DitroniX/IPEM-IoT-Power-Energy-Monitor/README.md

## IPEM ESP32 ATM90E32 ATM90E36 IoT Power Energy Monitor SDK

### NOTE: 20th March 2026. This version of IPEM has been superseded with the new improved [IPEM Plus](https://github.com/DitroniX/IPEM-Plus-ESP32-C5-LoRa-LoRaWAN-IoT-Mains-Power-Energy-Monitor)
**IPEM Plus**  is a self-contained ESP32-C5 based IoT monitoring board. Ideal for local, or remoting, monitoring requirements.

**IPEM Plus**  connectivity allows Wi-Fi connections to 2.4GHz or 5GHz, with Bluetooth, Thread and Zigbee. In addition, you may also use the inbuilt LoRa Radio IoT 850 MHz through to 930 MHz.

### [Compare Mains Power IoT Energy Monitors](https://github.com/DitroniX/IPEM-Plus-ESP32-C5-LoRa-LoRaWAN-IoT-Mains-Power-Energy-Monitor/wiki/Compare-Mains-Power-IoT-Energy-Monitors)
-----------
### Original IPEM E32 and E36

**250112 UPDATED FIRMWARE**: [**FliX**](https://github.com/DitroniX/FLIX-DitroniX-Power-Energy-Monitors-Firmware) is an Integrated Firmware for DitroniX Power Energy Monitor SDK Boards

IPEM Overview
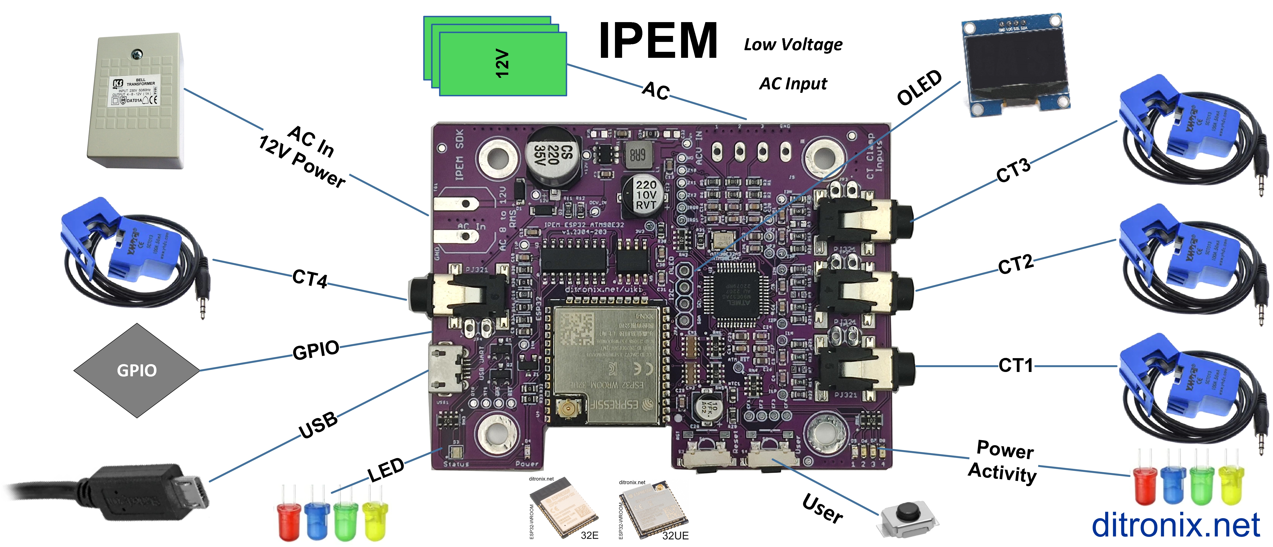
[picture p1: Datasheets and Information/IPEM Power Energy Monitor Board Overview.jpg]
Display-Type-B


The IPEM Kit
Display-Type-B

IPEM with OLED
Display-Type-B

**DitroniX.net Power Energy Monitor Boards SDK Overview**
Display-Type-B
------------

**IPEM Production - 3D Render**
Display-Type-B

**IPEM with Integrated Push OTA Example**
Display-Type-B
Display-Type-B 

**IPEM Example Real-Time Output to ThingSpeak**
Display-Type-B

**IPEM Example Real-Time Output to ThingSpeak into ThingChart on Mobile Phone App**
Display-Type-B

Four fully tested versions of this board are available. Thye most popular being ESP32E (PCB Ant), plus ATM90E32.

The board layout is designed to be a flexible dual purpose.
- ESP32 WROOM, with Internal Antenna, or UF.L connector for external antenna
- ATM90E32 or ATM90E36

**CT Clamp Inputs**

The forth CT input on the ATM90E32 board, which is included for the ATM90E36, now remains on the board and goes to the ESP32 ADC.  So both 
board variants will have FOUR CT inputs. 

- **ATM90E32**
 - 3 x CT Line inputs to the ATM chip.
 - 1 x CT input to the ESP32 ADC.

- **ATM90E36**
 - 3 x CT Line inputs to the ATM chip.
 - 1 x CT N input to the ATM chip or CT to ESP32 ADC
 - Alternative 1 x CT input to the ESP32 ADC.

------------

**IPEM with Transformer**

Display-Type-B

 The **IPEM IoT Power Energy Monitor** board main features:
 - **Compact** and **Flexible Design** SDK Board
	 - All connections are **low voltage**, for **safe operation**
	 - **Easy to interface**
 - *Optional* **Espressif** **ESP32** **WROOM**
	 - **ESP32-WROOM-32E-N4** 
		 - Integral Antenna Wireless and Bluetooth  
	 - **ESP32-WROOM-32UE-N4** 
		 - Ext Antenna - U.FL Socket 
		 - Wireless and Bluetooth
 - *Optional* **ATM90E** Series
	 - **ATM90E32** Energy Monitor 
		 - 3 x Phases Line CT Clamp Input  
			 -  Example YHDC SCT013000
		 - 3 x Voltage Inputs (AC RMS)
		 - Power Modes Settings
	 - **ATM90E36** Energy Monitor 
		 - 3 x Phases Line CT Clamp Input 
			 -  Example YHDC SCT013000
		 - 3 x Voltage Inputs (AC RMS) 
		 - 1 x Phase Neutral CT Clamp
		 - DMA Mode (Logging via SPI)
		 - Power Modes Settings
		 - Auto DMA selection opton via GP12
 - **24C64** EEPROM 
	 - Parameter Settings
	 - Logging
 - **OLED I2C**
	 - I2C Interface
	 - OLED I2C Connector
		 - Configurable Power Pins
 - **AC Low Voltage** Input (for Safety)
	 - Power safely derived from a SELV / Wall AC/AC Power Supply 
		 - 8 to 12V AC RMS
		 - Examples GreenBrook DAT01A or TLC TC TR7
 - Onboard **3V3 DC SMPS** Power Supply
	 - Power taken from AC Input
 - Arduino **Wemos D1 Compatible** USB Interface
	 - On-board Micro USB Socket
	 - Flashing and Programming
	 - Example wemos_d1_mini32
	 - Can also used to power the board
	 - Debugging
 - On Board **NTC** (Temperature) 
 - **USER GPIO/UART**
	 - 2 GPIO for User (GP16 and GP17)
	 - UART Interfacing (UART 2)
 - **Reset Button** 
 - User **Programmable Button** 
 - **RGB Status LED**
	 - User Configurable
 - **Power LED**
	 - On 3V3 
 - **ATM CT LEDs**
	 - CF1 - Active 
	 - CF2 - ReActive
	 - CF3 - Fundamental
	 - CF4 - Harmonic
 - PCB designed to fit into an BMC enclosure 
	 - Also allows for the display to be included, or not. 
 - **Size** 70 mm x 53 mm

------------

**In The Box**

Display-Type-B

External Antenna Version
Display-Type-B

Our SDKs are WeMos D1 Mini flashing compatible
Set the BOARD to ESP32, 'WEMOS D1 MINI ESP32' DEV Module (or similar).
You can also set the BAUD rate to 921600 to speed up flashing.
The SDK does NOT need external power to flash. It will take Power from the USB 5V.
You will need to provide external 12V AC for power up of the Energy Monitor functions. You will need to provide a CT Current Clamp. Ideally YHDC SCT-013-000

All test code is OPEN SOURCE and although is is not intended for real world use, it may be freely used, or modified as needed. It is distributed on an "AS IS" BASIS, WITHOUT WARRANTIES OR CONDITIONS OF ANY KIND, either express or implied.

## **Purchase**
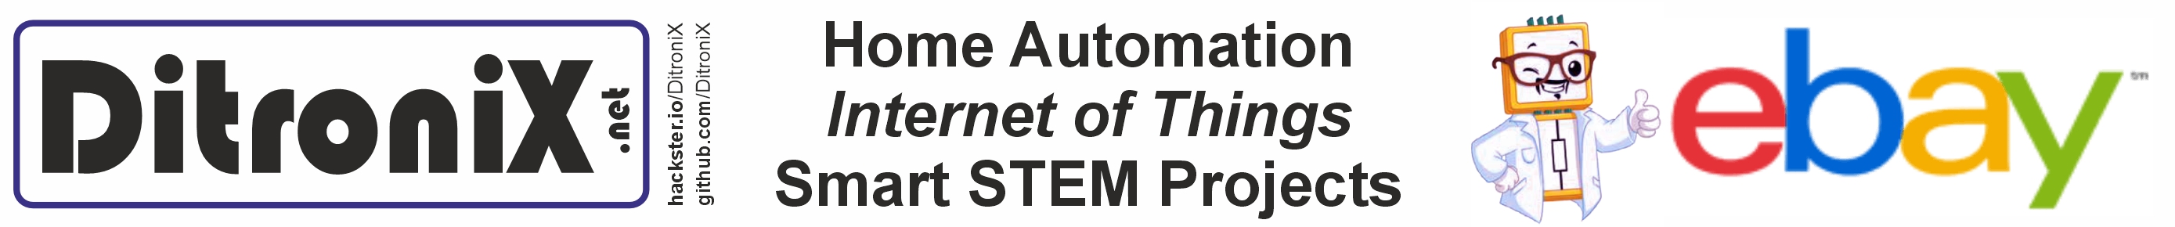
[picture p2: Datasheets and Information/DitroniX.net STEM IoT eBay.jpg]
Display-Type-B (https://www.ebay.co.uk/usr/ditronixuk)


Our STEM SDK boards and accessories are available from our online shops on [eBay](https://www.ebay.co.uk/usr/ditronixuk) 
## **Further Information**

Additional information, and other technical details on this project, maybe found in the related repository pages.

**Repository Folders**

 - **Code** *(Code examples for Arduino  IDE and PlatformIO)*
 -  **Datasheets and Information** *(Component Datasheets, Schematics, Board Layouts, Photos, Technical Documentation)*
 - **Certification** *(Related Repository Project or Part, Certification Information)*

**Repository Tabs**

 - **Wiki** *(Related Repository Wiki pages and Technical User Information)*
 - **Discussions** *(Related Repository User Discussion Forum)*
 - **Issues** *(Related Repository Technical Issues and Fixes)*

***

We value our Customers, Users of our designs and STEM Communities, all over the World . Should you have any other questions, or feedback to share to others, please feel free to:

* Visit the related [Project](https://github.com/DitroniX?tab=repositories) *plus the related* **Discussions** and **Wiki** Pages.  See tab in each separate repository.
* **Project Community Information** can be found at https://www.hackster.io/DitroniX
* [DitroniX.net Website - Contact Us](https://ditronix.net/contact/)
* **Twitter**: [https://twitter.com/DitroniX](https://twitter.com/DitroniX)
* [Supporting the STEM Projects - BuyMeACoffee](https://www.buymeacoffee.com/DitroniX)
*  **LinkedIN**: [https://www.linkedin.com/in/g8puo/](https://www.linkedin.com/in/g8puo/)

***Dave Williams, Maidstone, UK.***

Electronics Engineer | Software Developer | R&D Support | RF Engineering | Product Certification and Testing | STEM Ambassador

## STEM

**Supporting [STEM Learning](https://www.stem.org.uk/)**

Life is one long exciting learning curve, help others by setting the seed to knowledge.
