DitroniX/IPEM-IoT-Power-Energy-Monitor/Transformer Info.txt

Example Double Insulated Bell Chime Transformer Part Number DAT01A (Greenbrook.co.uk)
In-built thermal cut-out, short circuit and overload protection self re-setting. 4/8/12V AC Output @ 1A.

Datasheet https://www.greenbrook.co.uk/pub/media/pdfs/DAT01AIns.pdf

Available from a number of distributors, example https://www.tlc-direct.co.uk/Products/TCTR7.html

Mains Input
246.2V RMS AC 

Secondary Output
4 = 6.4V RMS AC    	
8 = 12.8V RMS AC	16.43 DC
12 = 19.23V RMS AC	

The 12V Output setting performs the best and IPEM ATM90E32 VP Input has been designed for this.

Note: IPEM AP SMPS Regulator Input Voltage, Absolute Max: 32 V DC

## **Further Information**

Additional information, and other technical details on this project, maybe found in the related repository pages.

**Repository Folders**

 - **Code** *(Code examples for Arduino  IDE and PlatformIO)*
 -  **Datasheets and Information** *(Component Datasheets, Schematics, Board Layouts, Photos, Technical Documentation)*
 - **Certification** *(Related Repository Project or Part, Certification Information)*

**Repository Tabs**

 - **Wiki** *(Related Repository Wiki pages and Technical User Information)*
 - **Discussions** *(Related Repository User Discussion Forum)*
 - **Issues** *(Related Repository Technical Issues and Fixes)*

***

We value our Customers, Users of our designs and STEM Communities, all over the World . Should you have any other questions, or feedback to share to others, please feel free to:

* Visit the related [Project](https://github.com/DitroniX?tab=repositories) *plus the related* **Discussions** and **Wiki** Pages.  See tab in each separate repository.
* **Project Community Information** can be found at https://www.hackster.io/DitroniX
* [DitroniX.net Website - Contact Us](https://ditronix.net/contact/)
* **Twitter**: [https://twitter.com/DitroniX](https://twitter.com/DitroniX)
* [Supporting the STEM Projects - BuyMeACoffee](https://www.buymeacoffee.com/DitroniX)
*  **LinkedIN**: [https://www.linkedin.com/in/g8puo/](https://www.linkedin.com/in/g8puo/)

***Dave Williams, Maidstone, UK.***

Electronics Engineer | Software Developer | R&D Support | RF Engineering | Product Certification and Testing | STEM Ambassador

## STEM

**Supporting [STEM Learning](https://www.stem.org.uk/)**

Life is one long exciting learning curve, help others by setting the seed to knowledge.
