DitroniX/IPEM-IoT-Power-Energy-Monitor/Certification/ESP-WROOM-32 BQB Certification.pdf

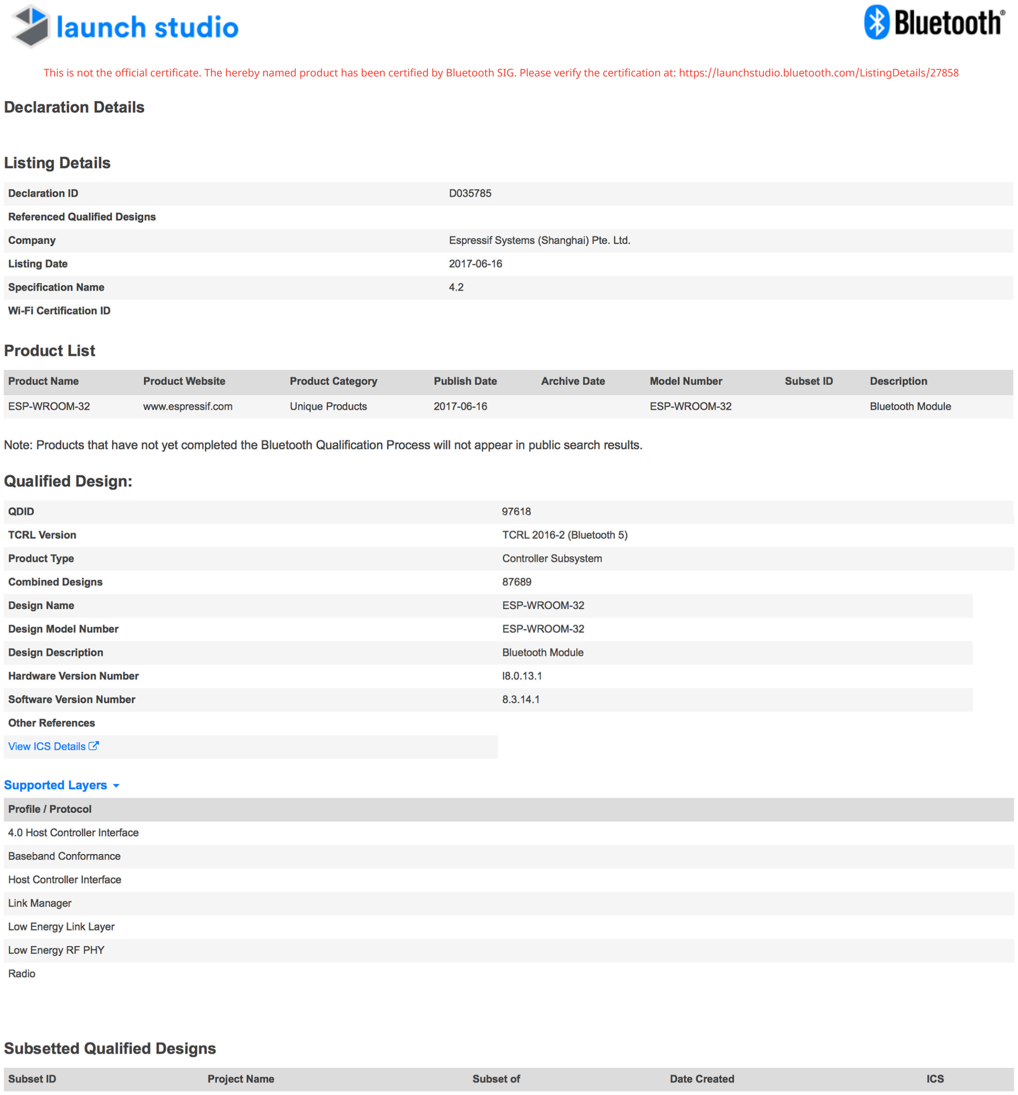
[picture p3: page 1]

This is not the official certificate. The hereby named product has been certified by Bluetooth SIG. Please verify the certification at: https://launchstudio.bluetooth.com/ListingDetails/27858
