DitroniX/IPEM-IoT-Power-Energy-Monitor/Certification/ESP-WROOM-32 SRRC Certification.pdf

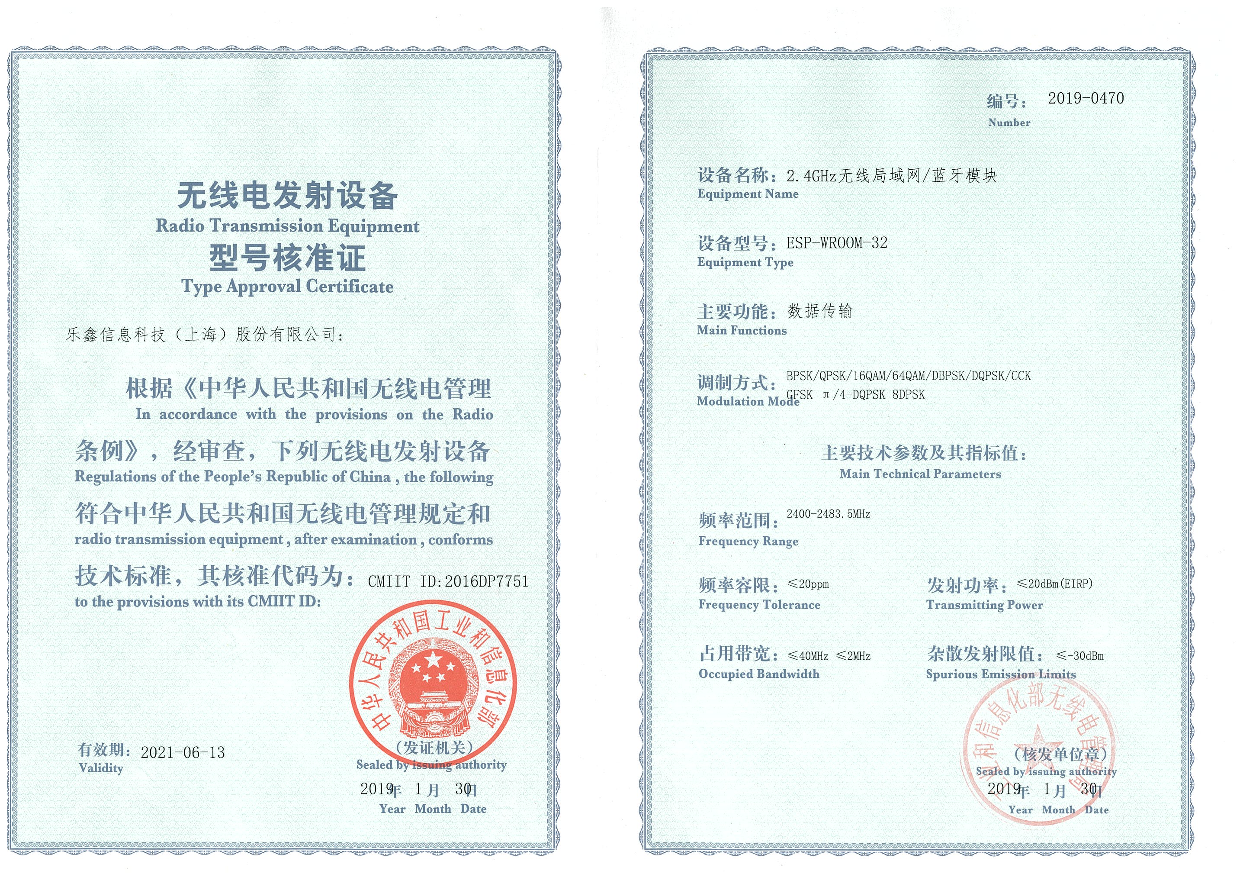
[picture p4: page 1]
