DitroniX/IPEM-IoT-Power-Energy-Monitor/Certification/ESP32-WROOM-32 NCC Certification.pdf

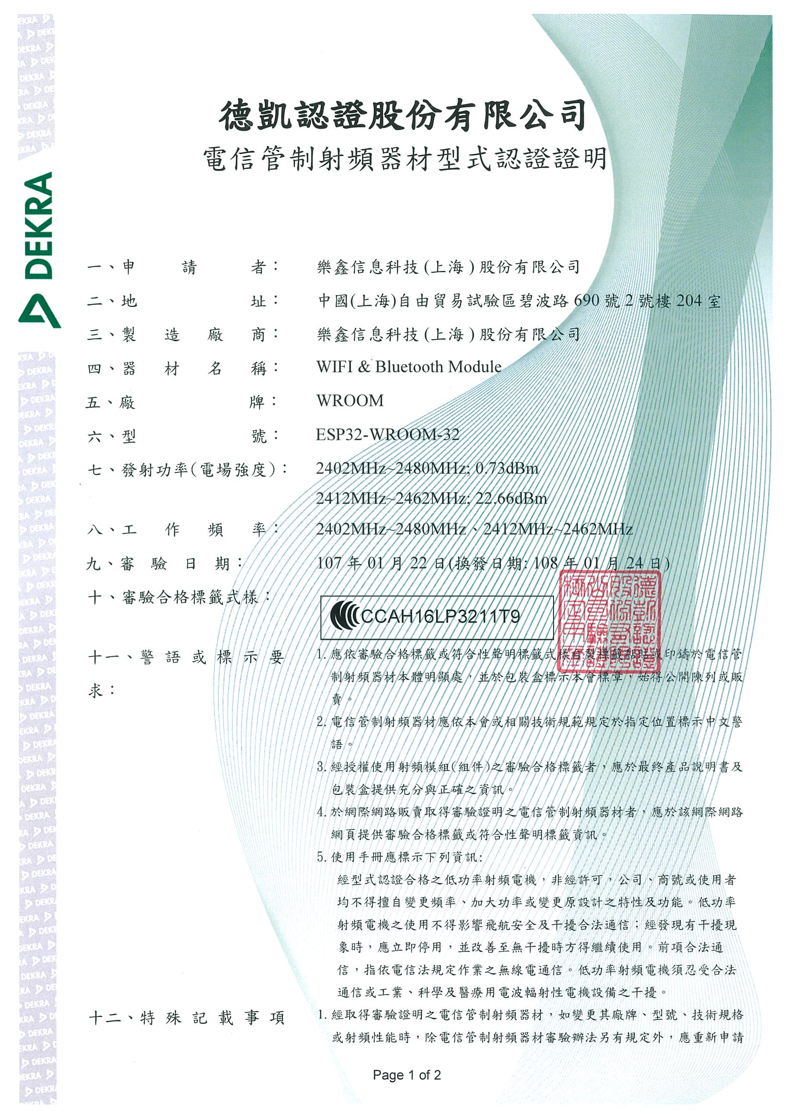
[picture p5: page 1]
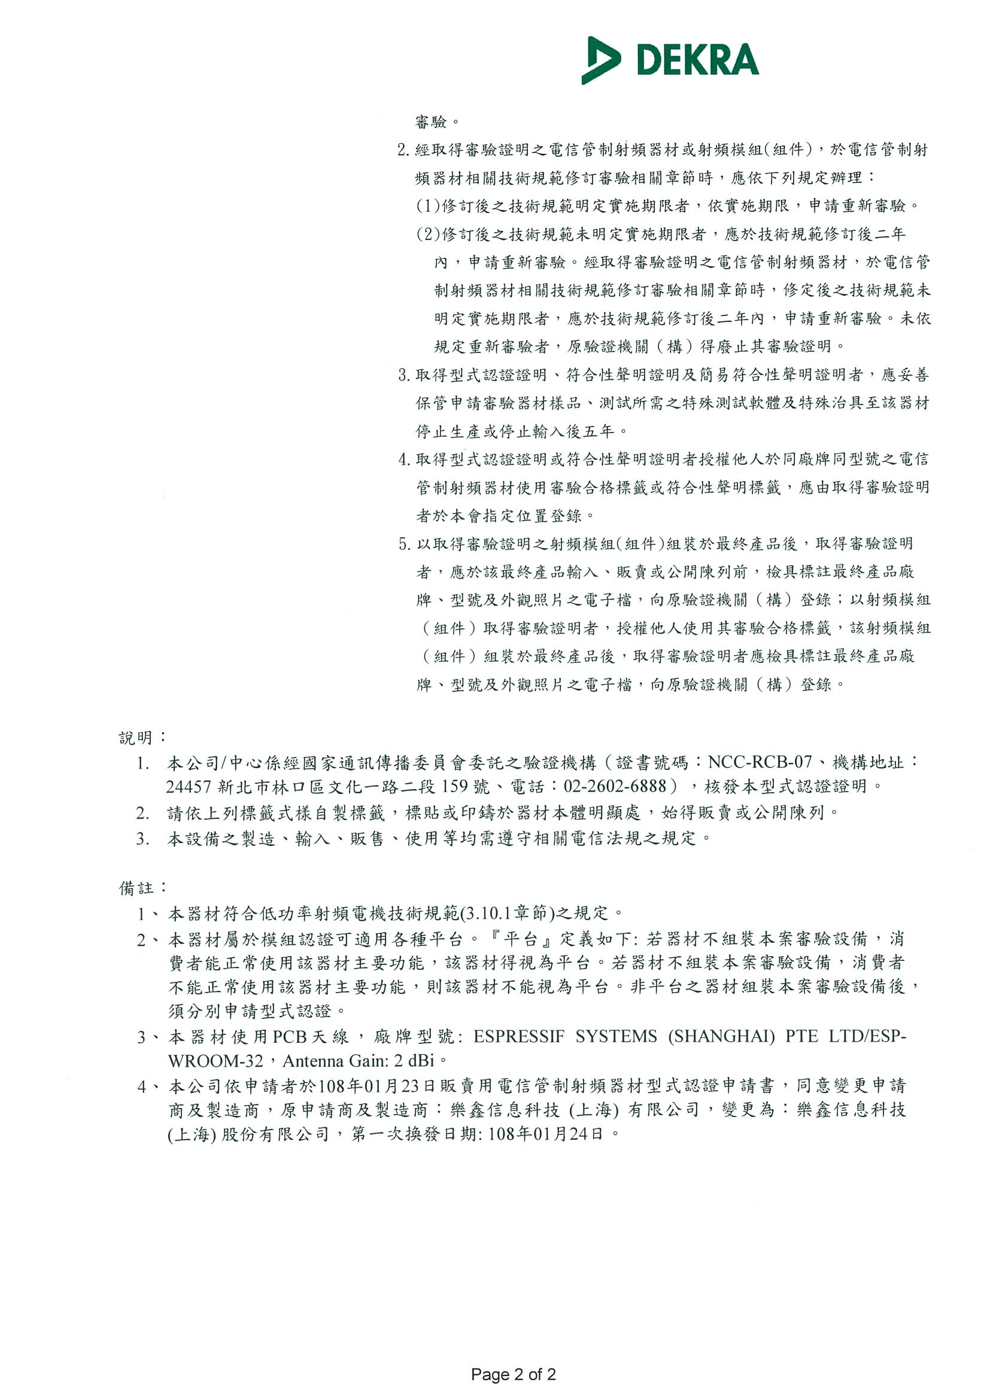
[picture p6: page 2]
