DitroniX/IPEM-IoT-Power-Energy-Monitor/Certification/ESP32-WROOM-32 SRRC Certification.pdf

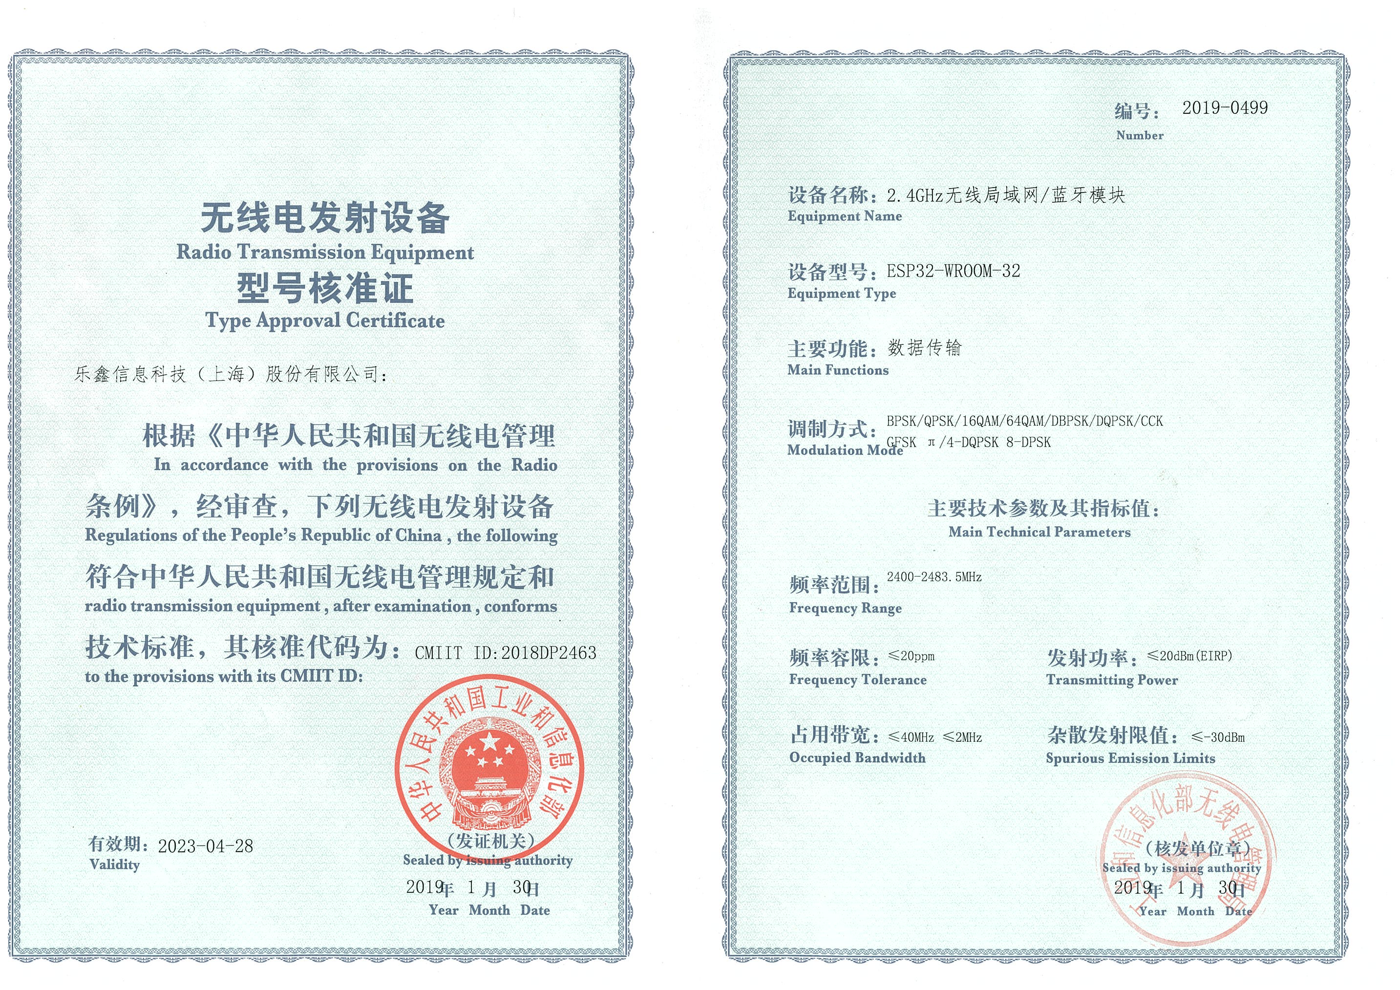
[picture p7: page 1]
