DitroniX/IPEM-IoT-Power-Energy-Monitor/Datasheets and Information/AC Three Phase Sinewave Plot.jpg

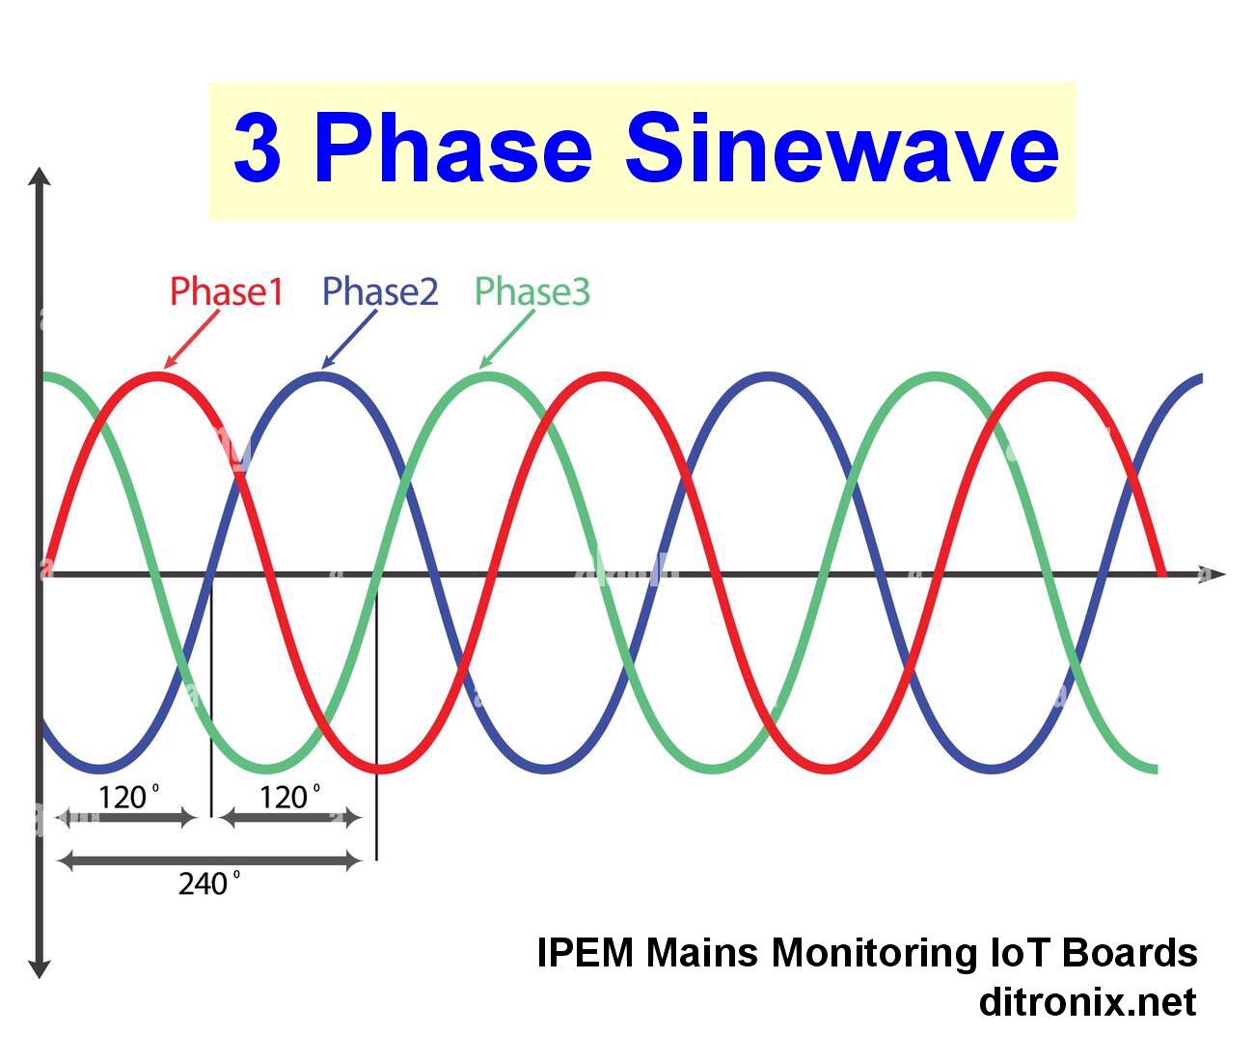
Datasheets and Information/AC Three Phase Sinewave Plot.jpg
