DitroniX/IPEM-IoT-Power-Energy-Monitor/Datasheets and Information/DitroniX.net STEM Energy Monitors SDK Board Options.jpg

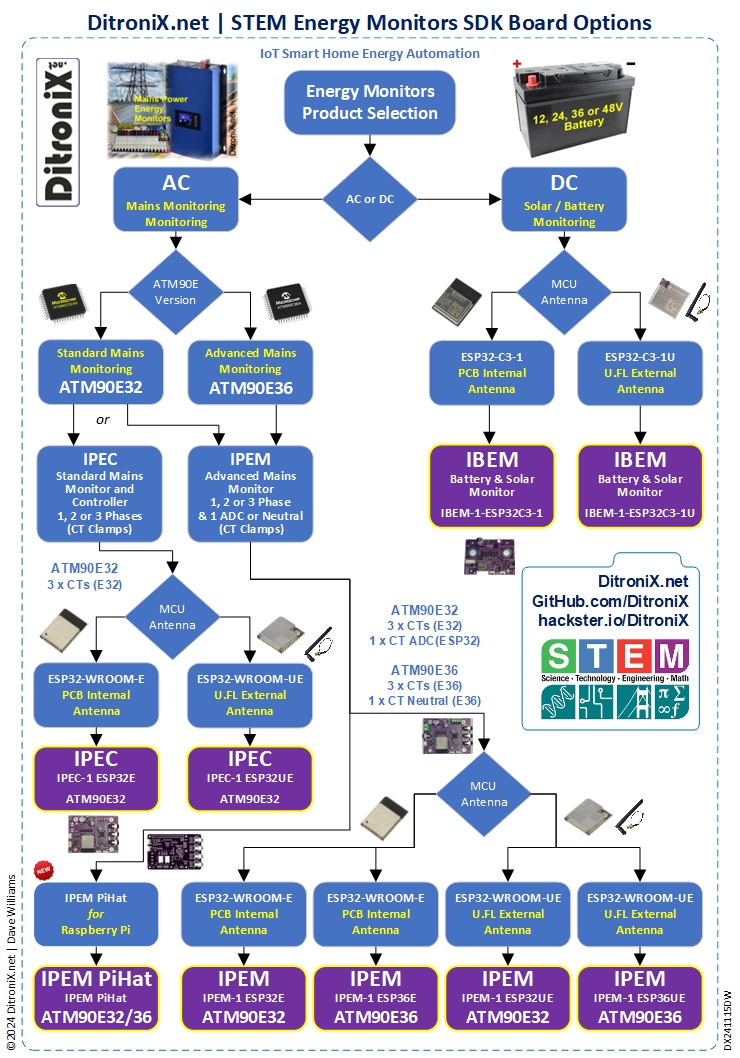
Datasheets and Information/DitroniX.net STEM Energy Monitors SDK Board Options.jpg
