DitroniX/IPEM-IoT-Power-Energy-Monitor/Datasheets and Information/IPEM AC Input Connections.png

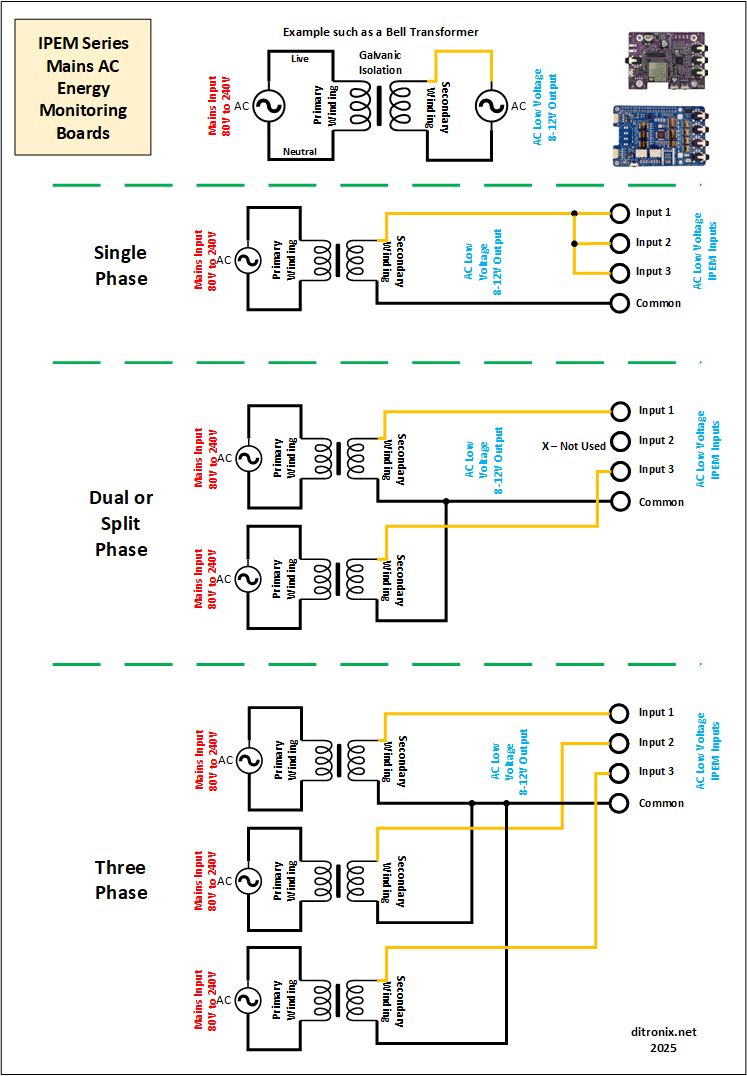
Datasheets and Information/IPEM AC Input Connections.png
