DitroniX/IPEM-IoT-Power-Energy-Monitor/Datasheets and Information/IPEM ArduinoISE - Serial Monitor.png

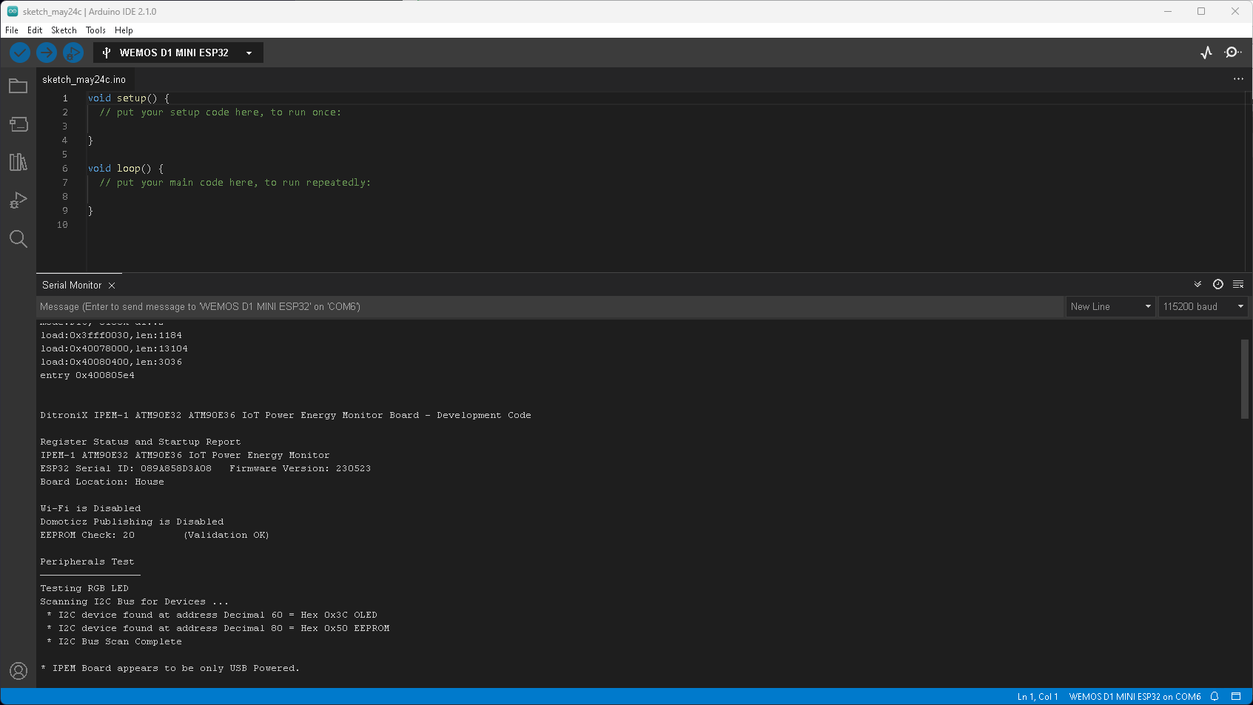
Datasheets and Information/IPEM ArduinoISE - Serial Monitor.png
