DitroniX/IPEM-IoT-Power-Energy-Monitor/Datasheets and Information/IPEM ESP32 ATM90E3x SDK 1.2302-202P Schematic.png

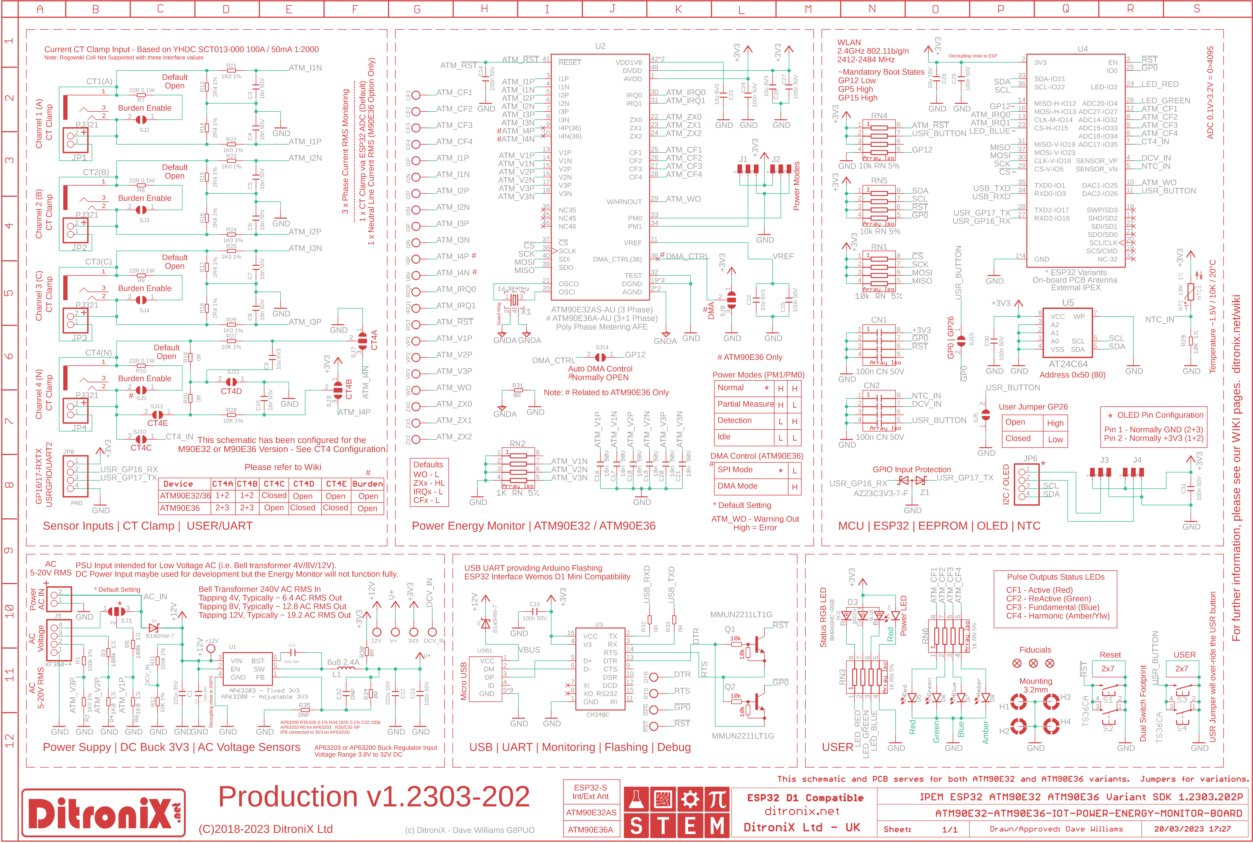
Datasheets and Information/IPEM ESP32 ATM90E3x SDK 1.2302-202P Schematic.png
