DitroniX/IPEM-IoT-Power-Energy-Monitor/Datasheets and Information/IPEM PlatformIO - Home.png

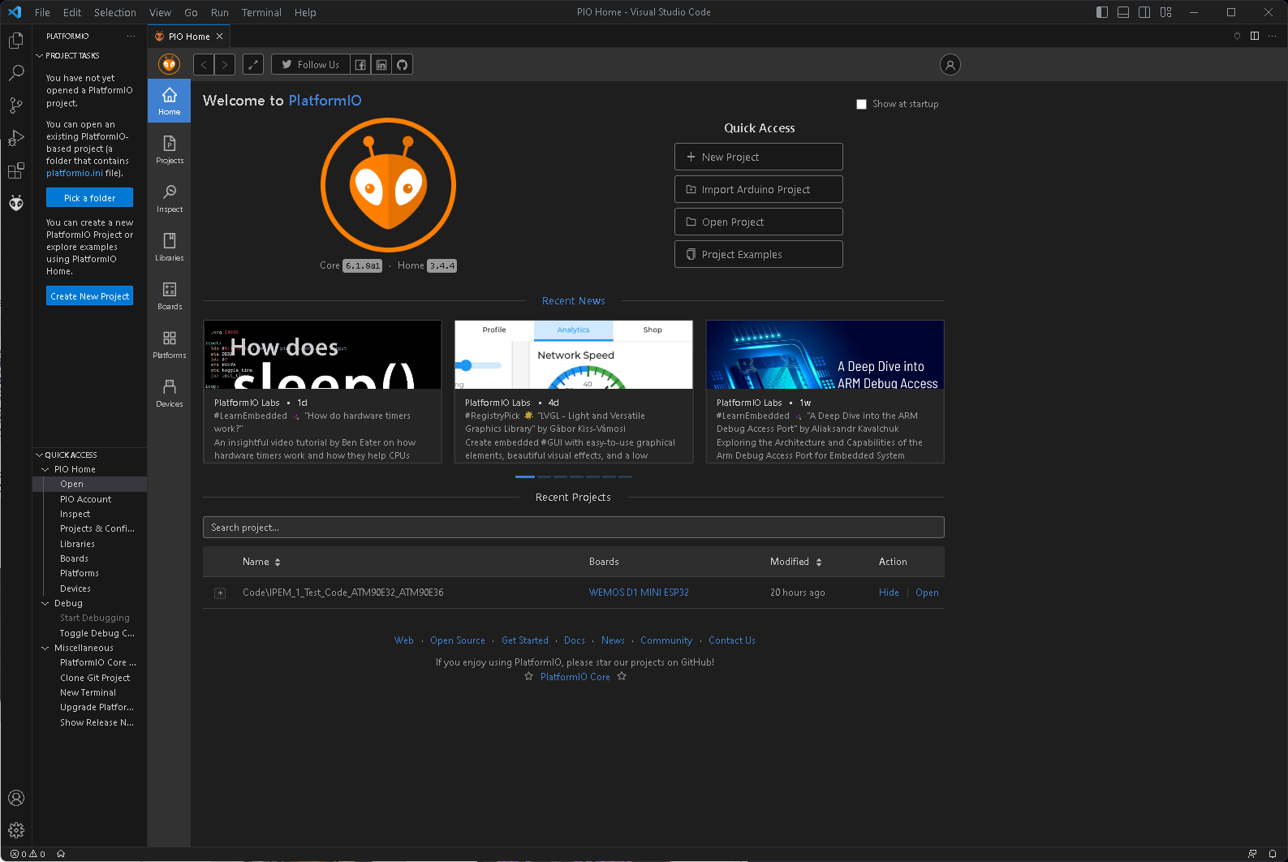
Datasheets and Information/IPEM PlatformIO - Home.png
