DitroniX/IPEM-IoT-Power-Energy-Monitor/Datasheets and Information/IPEM PlatformIO - MQTT Example in MQTT Explorer.png

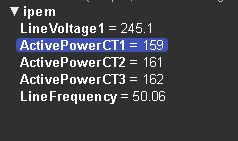
Datasheets and Information/IPEM PlatformIO - MQTT Example in MQTT Explorer.png
