DitroniX/IPEM-IoT-Power-Energy-Monitor/Datasheets and Information/IPEM PlatformIO - MQTT Example.png

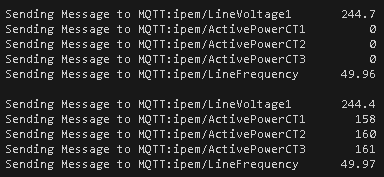
Datasheets and Information/IPEM PlatformIO - MQTT Example.png
