DitroniX/IPEM-IoT-Power-Energy-Monitor/Datasheets and Information/IPEM PlatformIO - Serial Monitor.png

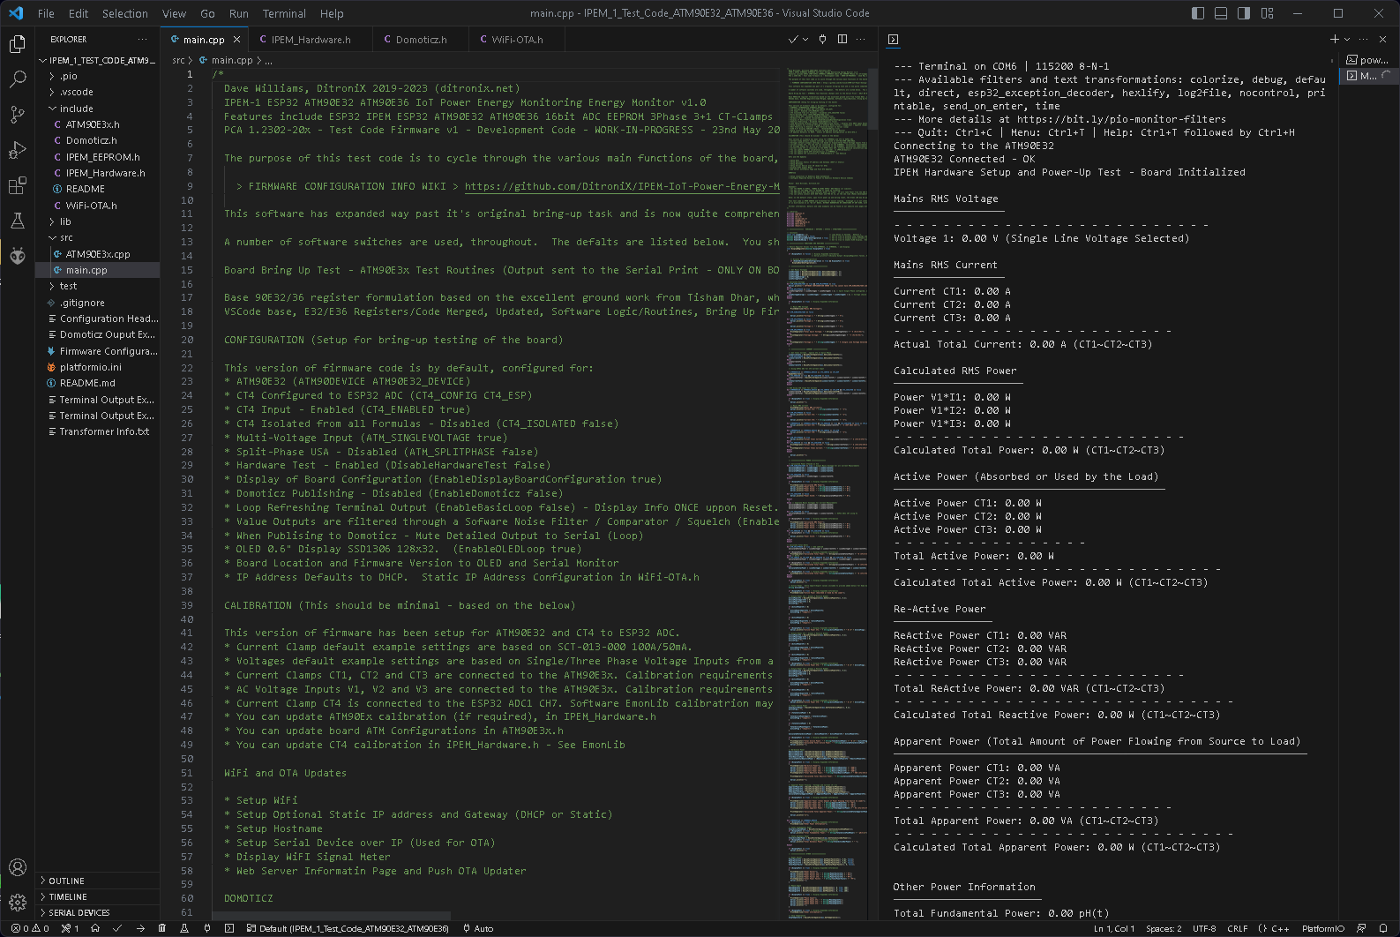
Datasheets and Information/IPEM PlatformIO - Serial Monitor.png
