DitroniX/IPEM-IoT-Power-Energy-Monitor/Datasheets and Information/IPEM PlatformIO - WiFi Settings.png

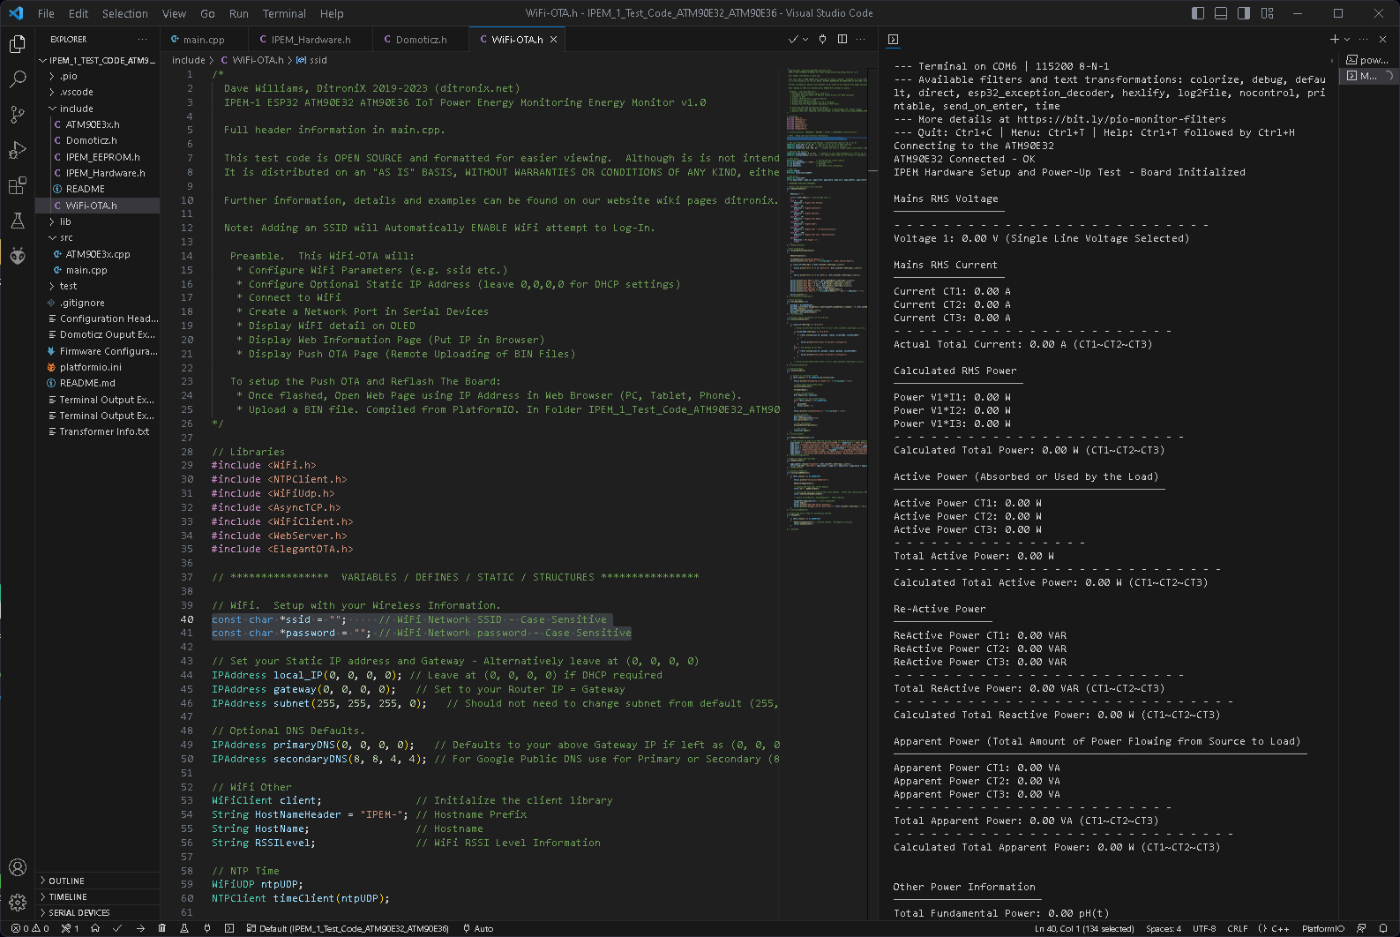
Datasheets and Information/IPEM PlatformIO - WiFi Settings.png
