DitroniX/IPEM-IoT-Power-Energy-Monitor/Datasheets and Information/IPEM Push OTA Web Home Page.png

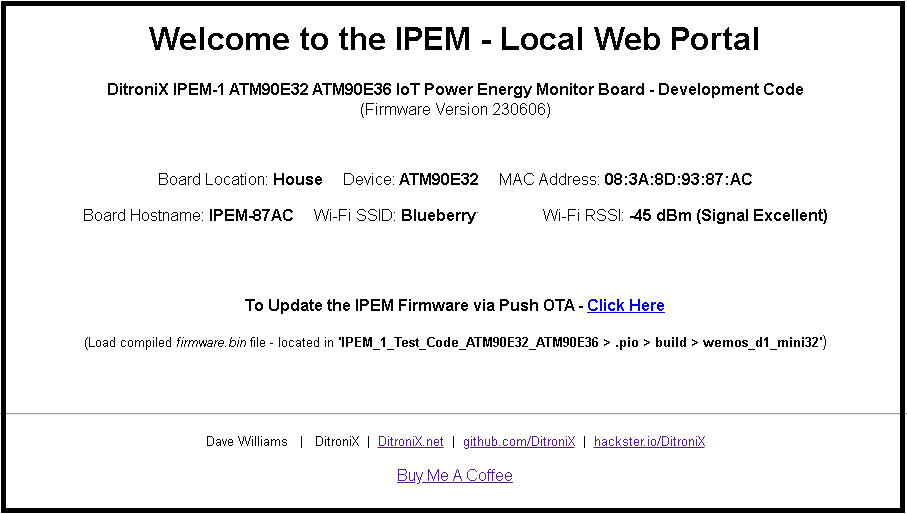
Datasheets and Information/IPEM Push OTA Web Home Page.png
