DitroniX/IPEM-IoT-Power-Energy-Monitor/Datasheets and Information/IPEM Push OTA Web Upload Page.png

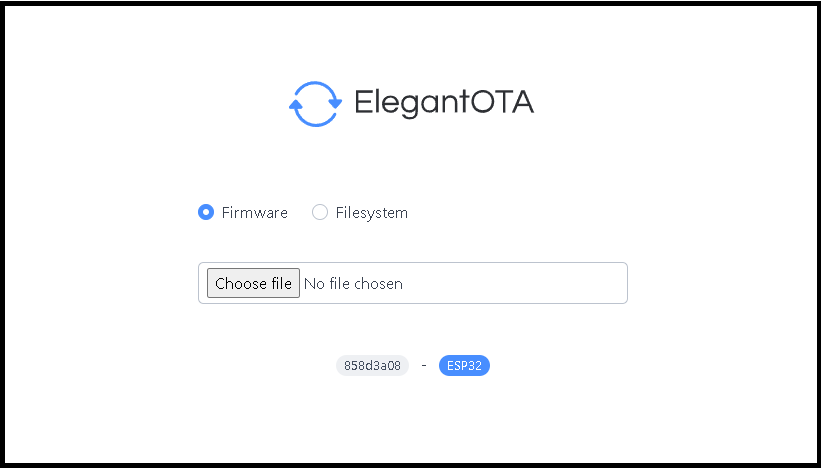
Datasheets and Information/IPEM Push OTA Web Upload Page.png
