DitroniX/IPEM-IoT-Power-Energy-Monitor/Datasheets and Information/IPEM ThingSpeak -  ThingChart App.jpg

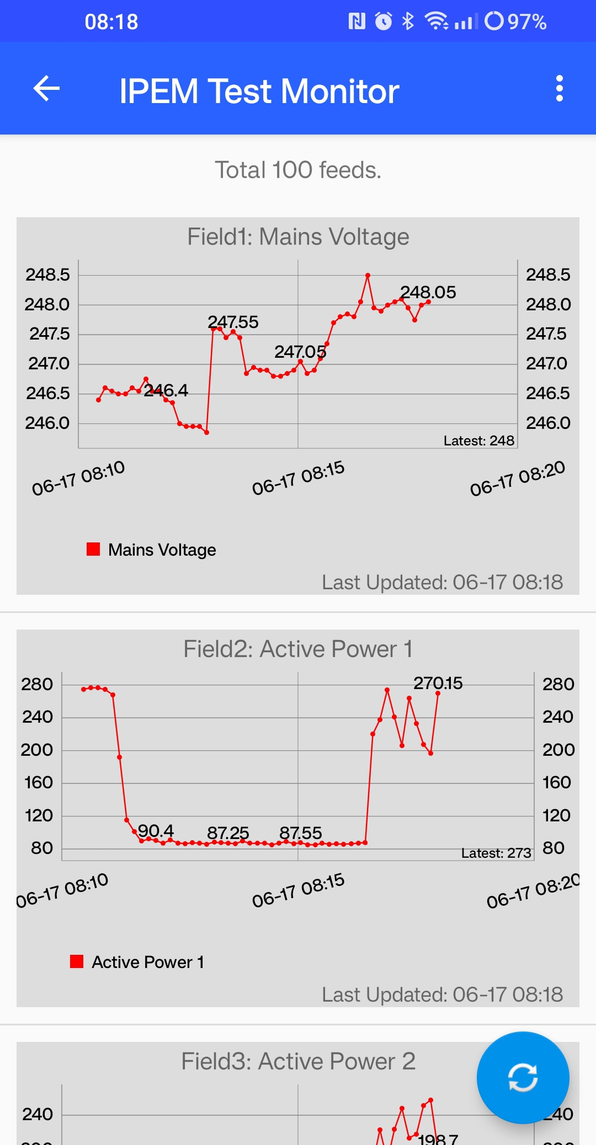
Datasheets and Information/IPEM ThingSpeak - ThingChart App.jpg
