DitroniX/IPEM-IoT-Power-Energy-Monitor/Datasheets and Information/IPEM ThingSpeak Example.png

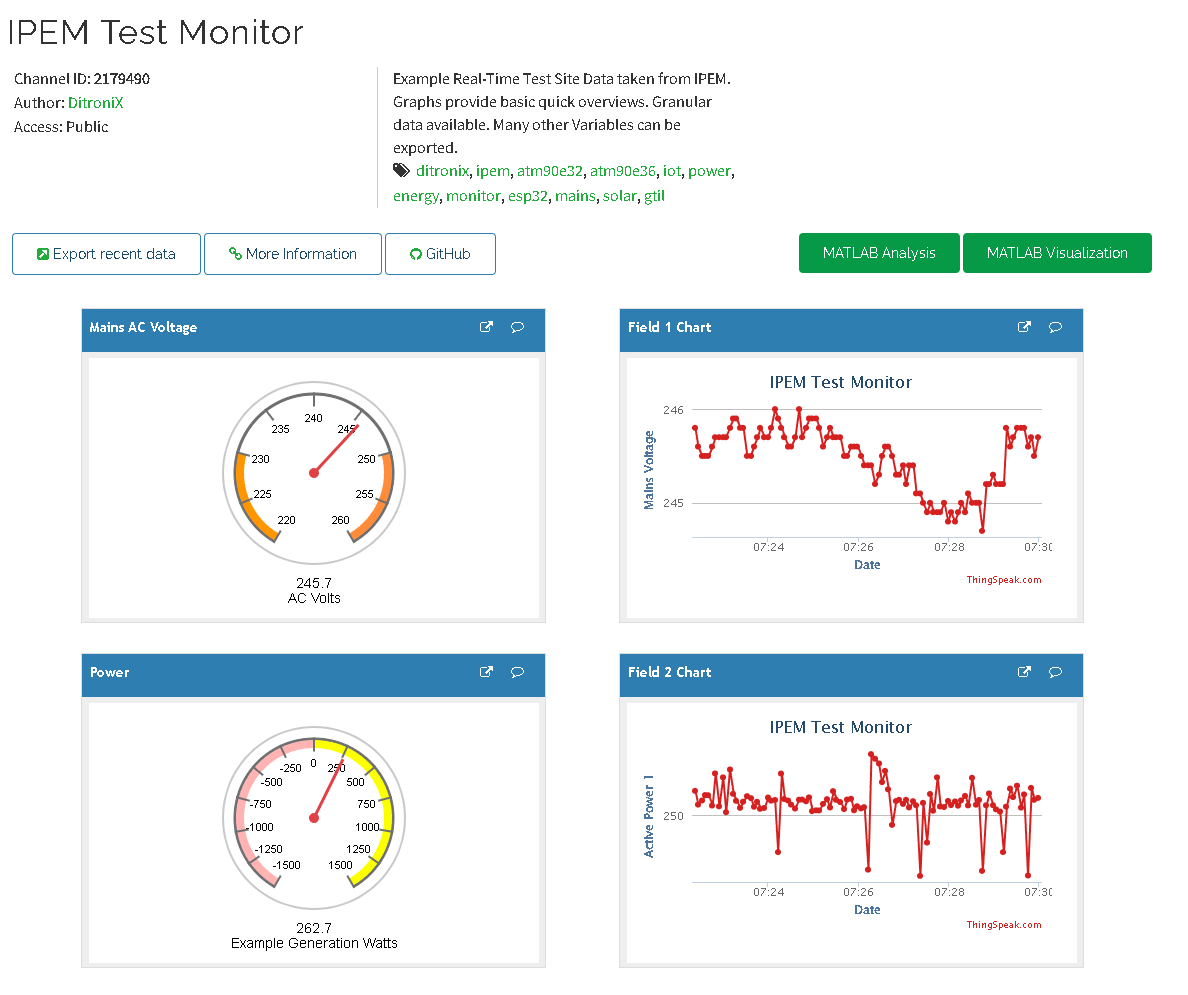
Datasheets and Information/IPEM ThingSpeak Example.png
