DitroniX/IPEM-IoT-Power-Energy-Monitor/Datasheets and Information/IPEM with OLED Display.jpg

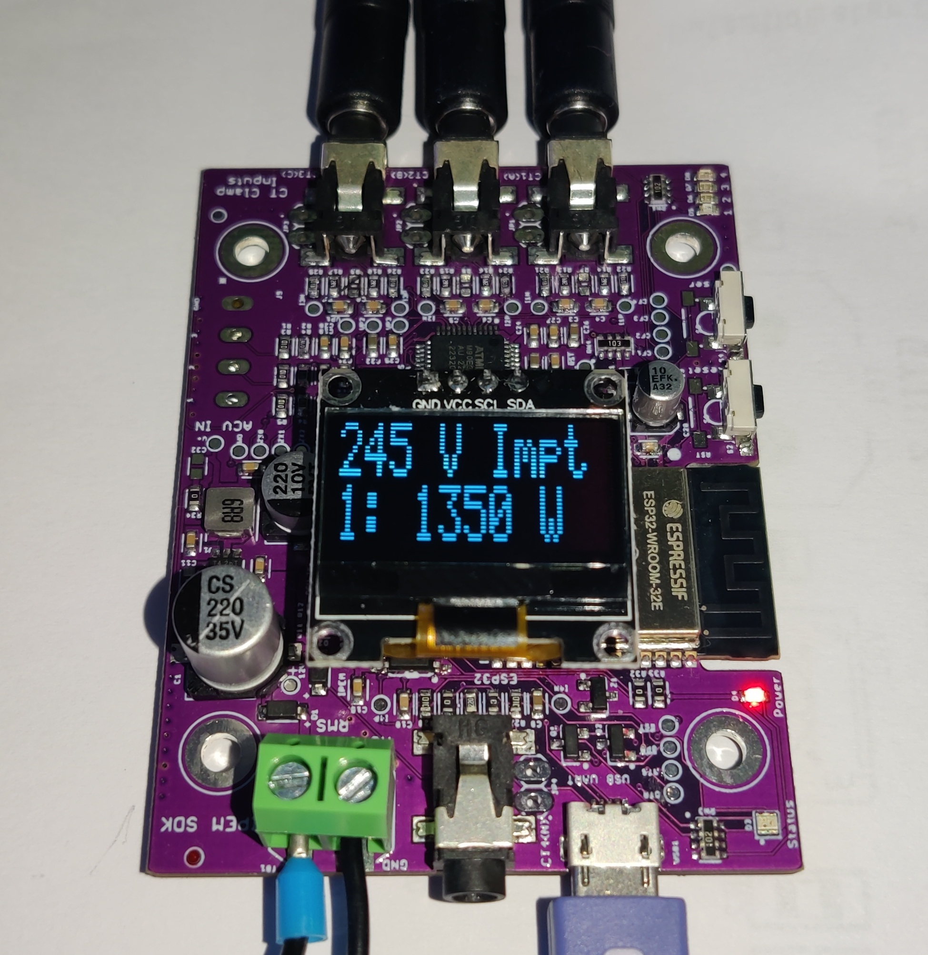
Datasheets and Information/IPEM with OLED Display.jpg
