DitroniX/IPEM-IoT-Power-Energy-Monitor/Datasheets and Information/IPEM-ESP32E-ATM90E32 - Shipping.jpg

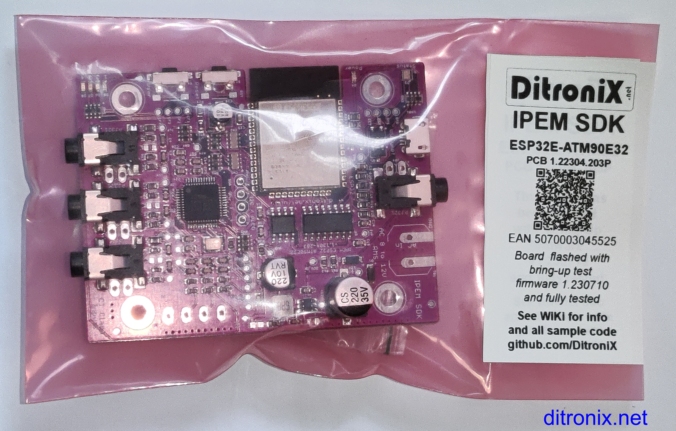
Datasheets and Information/IPEM-ESP32E-ATM90E32 - Shipping.jpg
