DitroniX/IPEM-IoT-Power-Energy-Monitor/Code/IPEM_1_Test_Code_ATM90E32_ATM90E36/Configuration Header Examples.md

**Below are EXAMPLE Configuration Outputs**

Hardware Configuration for ATM90E32
-----------------------------------
AC Voltage Inputs:      Multi Separated V1 V2 V3 - 3 Phase Configuration.
Split AC Voltage:       Dual Disabled
CT Current Clamp:       Configured for 1, 2, 3 Phase + 1 Phase (ESP32)
CT4 Current Input:      Configured for ESP32 ADC

Hardware Configuration for ATM90E32  
-----------------------------------
AC Voltage Inputs:      Single Input V1 will be used for all Current Phase Calculations
Split AC Voltage:       Dual Disabled
CT Current Clamps:      Configured for 1, 2, 3 Phase + 1 Phase (ESP32)
CT4 Current Input:      Configured for ESP32 ADC

Hardware Configuration for ATM90E32 ATM_SPLITPHASE ATM_SINGLEVOLTAGE
-----------------------------------
AC Voltage Inputs:      Single Input V1 will be used for all Current Phase Calculations
Split AC Voltage:       Configuration Error (Check ATM_SINGLEVOLTAGE)
CT4 Current Input:      Configured for ESP32 ADC

Hardware Configuration for ATM90E32 ATM_SPLITPHASE
-----------------------------------
AC Voltage Inputs:      Multi Dual V1 and V3 - USA Configuration
Split AC Voltage:       Dual Input V1 and V3 Enabled - USA Configuration
CT Current Clamps:      Phase Configured for 1 and 3  + 1 Phase (ESP32)
CT4 Current Input:      Configured for ESP32 ADC

Hardware Configuration for ATM90E32
-----------------------------------
* CONFIGURATION ERROR *
* You cannot have an ATM90E32 and I4N Input Selected (Change CT4_CONFIG) *

Hardware Configuration for ATM90E36 ATM_SPLITPHASE
-----------------------------------
AC Voltage Inputs:      Multi Dual V1 and V3 - USA Configuration
Split AC Voltage:       Dual Input V1 + V3 Enabled - USA Configuration
CT Current Clamps:      Phase Configured for 1 and 3 + 1 Phase (I4N)
CT4 Current Input:      Configured for I4N on the ATM90E36

Hardware Configuration for ATM90E36
-----------------------------------
AC Voltage Inputs:      Multi Separated V1 V2 V3 - 3 Phase Configuration.
Split AC Voltage:       Dual Disabled
CT Current Clamps:      Configured for 1, 2, 3 Phase + 1 Phase (I4N)
CT4 Current Input:      Configured for I4N on the ATM90E36

Hardware Configuration for ATM90E36 ATM_SINGLEVOLTAGE
-----------------------------------
AC Voltage Inputs:      Single Input V1 will be used for all Current Phase Calculations
Split AC Voltage:       Dual Disabled
CT Current Clamps:      Configured for 1, 2, 3 Phase + 1 Phase (I4N)
CT4 Current Input:      Configured for I4N on the ATM90E36
