DitroniX/IPEM-IoT-Power-Energy-Monitor/Datasheets and Information/DitronIX Mains Calibration TestBox CloseUp.jpg

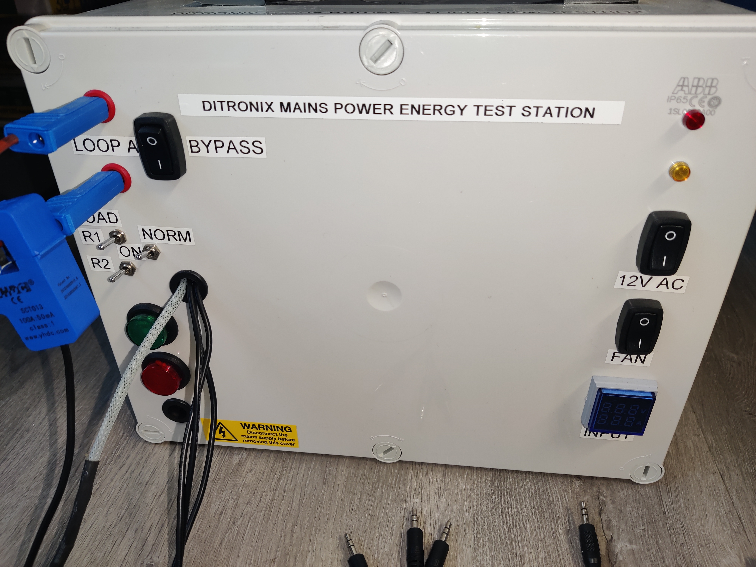
Datasheets and Information/DitronIX Mains Calibration TestBox CloseUp.jpg
