DitroniX/IPEM-IoT-Power-Energy-Monitor/Datasheets and Information/DitronIX Mains Calibration TestBox Loads.jpg

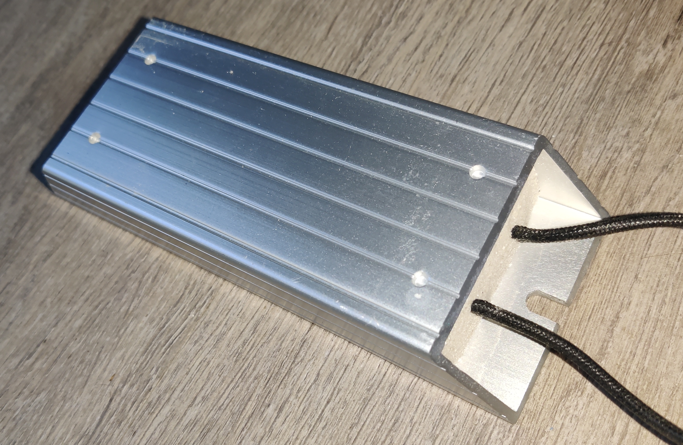
Datasheets and Information/DitronIX Mains Calibration TestBox Loads.jpg
