DitroniX/IPEM-IoT-Power-Energy-Monitor/Datasheets and Information/DitroniX Mains Test Fixture Outline IPEM 2303.jpg

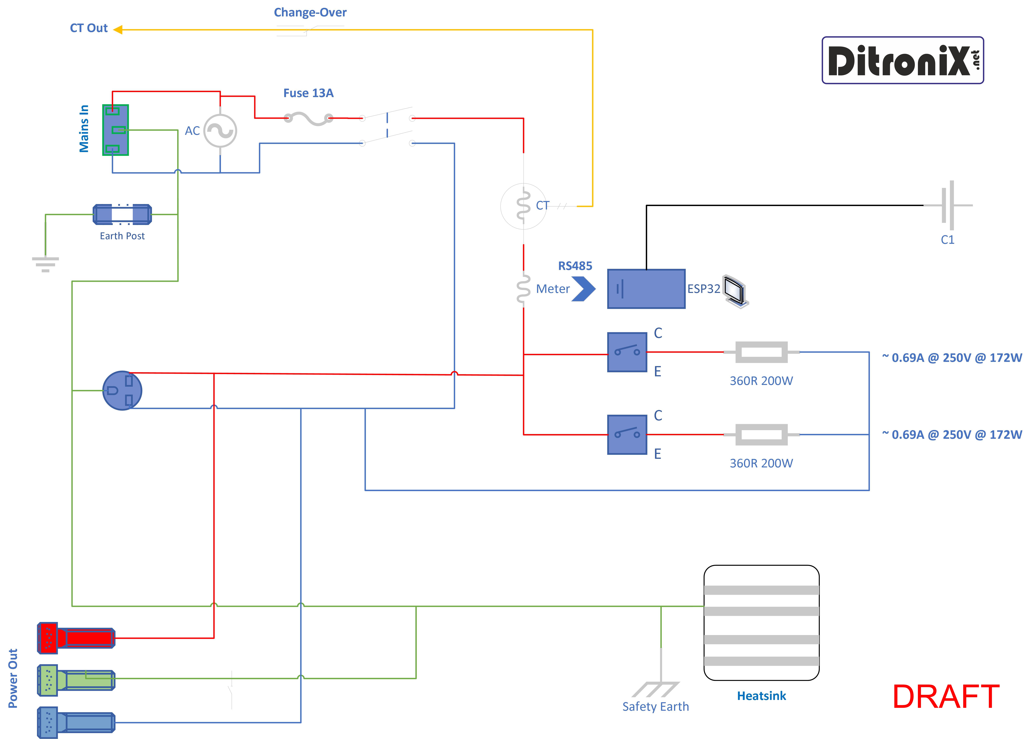
Datasheets and Information/DitroniX Mains Test Fixture Outline IPEM 2303.jpg
