DitroniX/IPEM-IoT-Power-Energy-Monitor/DitroniX.net Board Versions and Revisions.txt

For various production reasons and component availability, our boards may require update.  The below list contains any revision information summary.

  IPEM-1 ESP32 ATM90E32 ATM90E36 IoT Power Energy Monitoring Energy Monitor Board SDK
  Features include ESP32 IPEM ESP32 ATM90E32 ATM90E36 16bit ADC EEPROM 3Phase 3+N 3+1 CT-Clamps Current Voltage Frequency 

*Production*
1.2304-203	Exactly the same as 1.2303-202 but has BOM specific updates for the ESP32E ATM90E32 AP63203 Variant for production.
1.2303-202	Final Production Release, same as 1.2302-201 but has reverted back to a CH340C and has an additional GP0/GP26 Link.

*Pre-Production*
1.2303-201	Pre-Production Release, same as 1.2302-201 but has schematic text changes so both variants option CT4 with ESP32 ADC
1.2302-201	Pre-Production Release.  Last minuted change from CH340C to CH340E due to supply issues.
1.2302-101	Beta Release

## **Further Information**

Additional information, and other technical details on this project, maybe found in the related repository pages.

**Repository Folders**

 - **Code** *(Code examples for Arduino  IDE and PlatformIO)*
 -  **Datasheets and Information** *(Component Datasheets, Schematics, Board Layouts, Photos, Technical Documentation)*
 - **Certification** *(Related Repository Project or Part, Certification Information)*

**Repository Tabs**

 - **Wiki** *(Related Repository Wiki pages and Technical User Information)*
 - **Discussions** *(Related Repository User Discussion Forum)*
 - **Issues** *(Related Repository Technical Issues and Fixes)*

***

We value our Customers, Users of our designs and STEM Communities, all over the World . Should you have any other questions, or feedback to share to others, please feel free to:

* Visit the related [Project](https://github.com/DitroniX?tab=repositories) *plus the related* **Discussions** and **Wiki** Pages.  See tab in each separate repository.
* **Project Community Information** can be found at https://www.hackster.io/DitroniX
* [DitroniX.net Website - Contact Us](https://ditronix.net/contact/)
* **Twitter**: [https://twitter.com/DitroniX](https://twitter.com/DitroniX)
* [Supporting the STEM Projects - BuyMeACoffee](https://www.buymeacoffee.com/DitroniX)
*  **LinkedIN**: [https://www.linkedin.com/in/g8puo/](https://www.linkedin.com/in/g8puo/)

***Dave Williams, Maidstone, UK.***

Electronics Engineer | Software Developer | R&D Support | RF Engineering | Product Certification and Testing | STEM Ambassador

## STEM

**Supporting [STEM Learning](https://www.stem.org.uk/)**

Life is one long exciting learning curve, help others by setting the seed to knowledge.
