DitroniX/IPEM-IoT-Power-Energy-Monitor/(commit log)

2023-03-18 IPEM ESP32 ATM90E32 AM90E36 Test Code - Initial Release v230318
    This is an initial release of code, configured for ESP32 and ATM90E32, with CT4 Enabled to ADC.
    Used for testing pre-production boards.
    [Configuration Header Examples.txt]
2023-03-20 IPEM ESP32 ATM90E3x SDK 1.2302-202P Schematic
    ATM90E32 Variant, with CT4 configured to the ESP32 ADC.
2023-03-22 IPEM ESP32 ATM90E32 AM90E36 Test Code - Initial Release v230322
    Tweaked Domoticz for Active Power Publish
    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
2023-03-31 IPEM Bring-Up Code Update
    Fix SINGLEVOLTAGE = True logic error when SPLITPHASE = false
    Default changed so SINGLEVOLTAGE = True
    Updated Console Output Example
    [ATM90E3x.h, Domoticz.h, IPEM_Hardware.h, main.cpp]
2023-04-04 Update DitroniX.net Board Versions and Revisions.txt
2023-04-21 Create ESP32-WROOM-32E Datasheet.pdf
2023-05-06 Added CT4_ISOLATED. ATM_SINGLEVOLTAGE Buglet fix
    Added CT4_ISOLATED, as master over-ride for Current Calculations.
    Corrected ATM_SINGLEVOLTAGE = True 'buglett', VoltageGain1/Ugain1 for all 3 inputs - Now correctly annotates for ATM values / Import and Export Calculations.
    [ATM90E3x.cpp, ATM90E3x.h, IPEM_Hardware.h, main.cpp]
2023-05-10 Added OTA WiFi Flashing - ArduinoOTA
    Updated code to include ArduinoOTA (PlatformIO).
    Additional configuration such as Static IP and HostName.
2023-05-21 Release 230520. Web Server, Push OTA, OLED Support, Various Improvements
    The latest updates include a range of improvements, Web Server, Push OTA, OLED Support, Increased Serial Monitor Information and a couple Buglet fixes.
    [Domoticz.h, IPEM_Hardware.h, WiFi-OTA.h, main.cpp]
2023-05-22 NoWLAN Fix. Board Location Field. OLED Updates.
    Fixed a small problem when no WLAN is configured and the application is run. Added a new field in IPEM_Hardware.h called LocationName, to store a board location when using more than one IPEM on a system. Added updates to OLED Info.
    [IPEM_EEPROM.h, IPEM_Hardware.h, WiFi-OTA.h, main.cpp]
2023-05-23 Minor Updates to align with Wiki updates
    https://github.com/DitroniX/IPEM-IoT-Power-Energy-Monitor/wiki/Firmware-Configuration-and-Flashing
2023-06-16 Various Updates. PWM and DAC Outputs tracking Power. WebServer Listener for Switches. Bug Fixes
    * Tweaks for Improvements
    * Added PWM Ouput which will monitor a designated CT Power variable and output PWM (default ActivePowerExportCT1). Output Updated on Each DisplayRegisters Loop (Only if Value Changed)
    * Added DAC Ouput which will monitor a designated CT Power variable and output a DAC Voltage 0-3.3 (default ActivePowerExportCT1). Output Updated on Each DisplayRegisters Loop (Only if Value Changed)
    * Webserver Listener for first round of Soft Web Controlled Switches. Can be driven from Browser URL, or Domoticz for example
    * PWM Switches added: /pwm-local, /pwm-remote, /pwm-on, /pwm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
    [ATM90E3x.cpp, ATM90E3x.h, DAC.h, Domoticz.h, IPEM_EEPROM.h, IPEM_Hardware.h, MQTT.h, PWM.h]
2023-06-16 PWM/DAC/WebServer Tweaks
2023-08-05 Power Energy Monitor Boards SDK Overview
2023-08-12 Mains Calibration TestBox
2024-05-21 IPEM Schematics
2024-10-28 DitroniX.net STEM Energy Monitors SDK Board Options
